McMax1973/ELS---Electronic-Lead-Screw/(threads)

Thread 1 (2023-03-30):

Informazioni

karnhack, 2023-03-30:
Ciao, scusa se uso la sezione issues ma vorrei farti alcune domande per favore.
Ho appena terminato il montaggio del pannello frontale versione 1.6 e solo ora mi sono accorto che il progetto è andato avanti qui su github. Vorrei sapere se questa versione 1.8  può utilizzare i componenti della precedente. In pratica l'LCD è simile ma nella versione precedente aveva il modulo i2c, togliendo il modulo i2c pensi possa adattarlo? (https://amzn.to/3M7CGiu)
Inoltre per quanto riguarda il joystick ho usato quello singolo senza tasti può essere ancora utilizzato? (https://amzn.to/3JZP8yg).
In più ci sono i tre tasti SEL, ESC, RES del progetto precedente. Il pannellino che ho realizzato è ultracompatto ed in pratica se dovessi aggiungere il joystick nuovo dovrei buttare tutto e rifare da capo.
Mi dai un consiglio su come è meglio procedere, magari anche in funzione di futuri aggiornamenti?
L'unica cosa che è andata bene è l'encoder che per sbaglio l'ho comprato a 600 passi e vedo che ora è supportato.
Grazie

Gianluca

Closed 2023-04-01.

Thread 2 (2023-04-02):

Inversione asse Y joystick

karnhack, 2023-04-02:
Ciao McMax1973, vorrei sapere se è possibile invertire la direzione dell'asse y agendo dal codice. Grazie mille

McMax1973, 2023-04-10:
si certo che è possibile ma va modificato il codice in ogni parte che legge il joystick Y. Fai molto prima ad invertire l'alimentazione del potenziometro.

Thread 3 (2023-11-12):

Versione 1.9

estami, 2023-11-12:
Ciao. Innanzitutto grazie per l'impegno che fai con questo programma e per averlo offerto gratuitamente. Sono spagnolo e seguo attentamente gli aggiornamenti dei file. Vedo che nel forum è stato pubblicato che è ora disponibile la versione 1.9 ma non sono riuscito a registrarmi nel forum e ho provato con diverse mie e-mail.
Saresti così gentile da pubblicarlo qui, vedo che l'ultima versione è la 1.82.
Sto utilizzando un traduttore per scrivere in italiano e non so se la traduzione è corretta, spero venga capita.
Per utilizzare il tuo programma traduco in spagnolo almeno le parti visualizzate sul display LCD. Se sei interessato posso fornirti le mie traduzioni per pubblicarle anche qui.
La mia email nel caso volessi contattarmi direttamente:   estami25@wanadoo.es
Grazie di tutto, riceva un cordiale saluto
